rullyadrian/octolight/(list of files, cad)

Other CAD files:
drawing/arduino-mkr.dwg
