rullyadrian/octolight/octolight.kicad_pcb

## KiCad design octolight.kicad_pcb (2019-12-01)

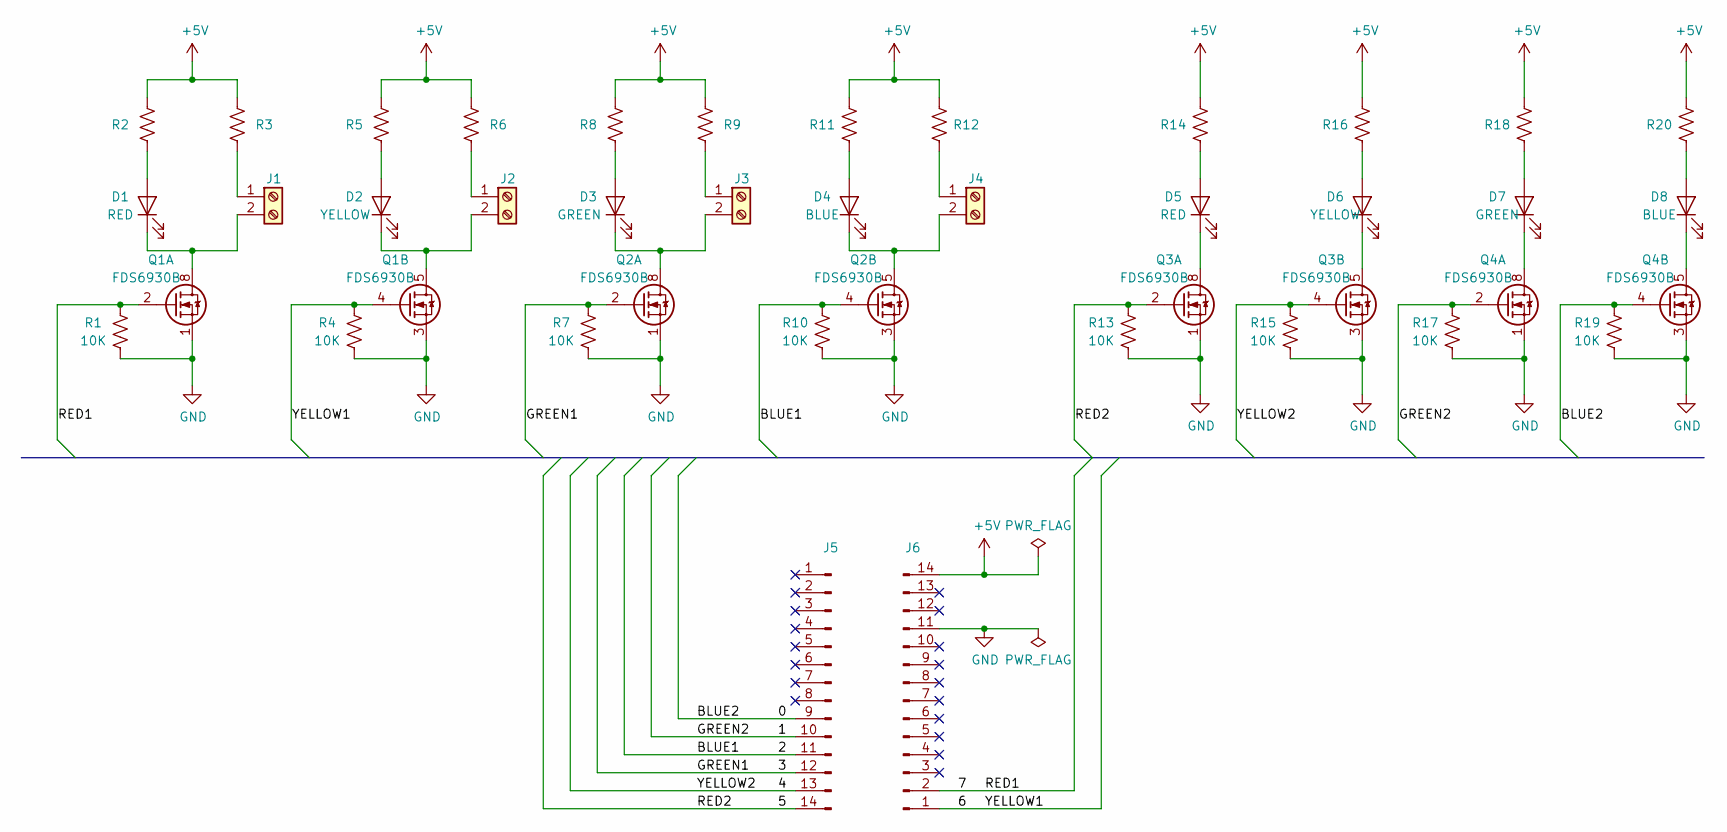
[picture p2: schematic octolight.sch]

Parts:
D1, D5: RED; LED_0805_2012Metric_Pad1.15x1.40mm_HandSolder
D2, D6: YELLOW; LED_0805_2012Metric_Pad1.15x1.40mm_HandSolder
D3, D7: GREEN; LED_0805_2012Metric_Pad1.15x1.40mm_HandSolder
D4, D8: BLUE; LED_0805_2012Metric_Pad1.15x1.40mm_HandSolder
J1, J2, J3, J4: Screw_Terminal_01x02; TerminalBlock_TE_282834-2_1x02_P2.54mm_Horizontal
J5, J6: Conn_01x14_Male; PinHeader_1x14_P2.54mm_Vertical
Q1, Q2, Q3, Q4: FDS6930B; SOIC-8_3.9x4.9mm_P1.27mm
R1, R4, R7, R10, R13, R15, R17, R19: 10K; R_0805_2012Metric_Pad1.15x1.40mm_HandSolder
R2, R3, R5, R6, R8, R9, R11, R12, R14, R16, R18, R20: R_US; R_0805_2012Metric_Pad1.15x1.40mm_HandSolder

Connections:
+5V: J6.14, R2.2, R3.2, R5.2, R6.2, R8.2, R9.2, R11.2, R12.2, R14.2, R16.2, R18.2, R20.2
/0: J5.9, Q4.4 (G2), R19.2
/1: J5.10, Q4.2 (G1), R17.2
/2: J5.11, Q2.4 (G2), R10.2
/3: J5.12, Q2.2 (G1), R7.2
/4: J5.13, Q3.4 (G2), R15.2
/5: J5.14, Q3.2 (G1), R13.2
/6: J6.1, Q1.4 (G2), R4.2
/7: J6.2, Q1.2 (G1), R1.2
GND: J6.11, Q1.1 (S1), Q1.3 (S2), Q2.1 (S1), Q2.3 (S2), Q3.1 (S1), Q3.3 (S2), Q4.1 (S1), Q4.3 (S2), R1.1, R4.1, R7.1, R10.1, R13.1, R15.1, R17.1, R19.1
unnamed: D1.1 (K), J1.2, Q1.7 (D1), Q1.8 (D1)
unnamed: D1.2 (A), R2.1
unnamed: D2.1 (K), J2.2, Q1.5 (D2), Q1.6 (D2)
unnamed: D2.2 (A), R5.1
unnamed: D3.1 (K), J3.2, Q2.7 (D1), Q2.8 (D1)
unnamed: D3.2 (A), R8.1
unnamed: D4.1 (K), J4.2, Q2.5 (D2), Q2.6 (D2)
unnamed: D4.2 (A), R11.1
unnamed: D5.1 (K), Q3.7 (D1), Q3.8 (D1)
unnamed: D5.2 (A), R14.1
unnamed: D6.1 (K), Q3.5 (D2), Q3.6 (D2)
unnamed: D6.2 (A), R16.1
unnamed: D7.1 (K), Q4.7 (D1), Q4.8 (D1)
unnamed: D7.2 (A), R18.1
unnamed: D8.1 (K), Q4.5 (D2), Q4.6 (D2)
unnamed: D8.2 (A), R20.1
unnamed: J1.1, R3.1
unnamed: J2.1, R6.1
unnamed: J3.1, R9.1
unnamed: J4.1, R12.1

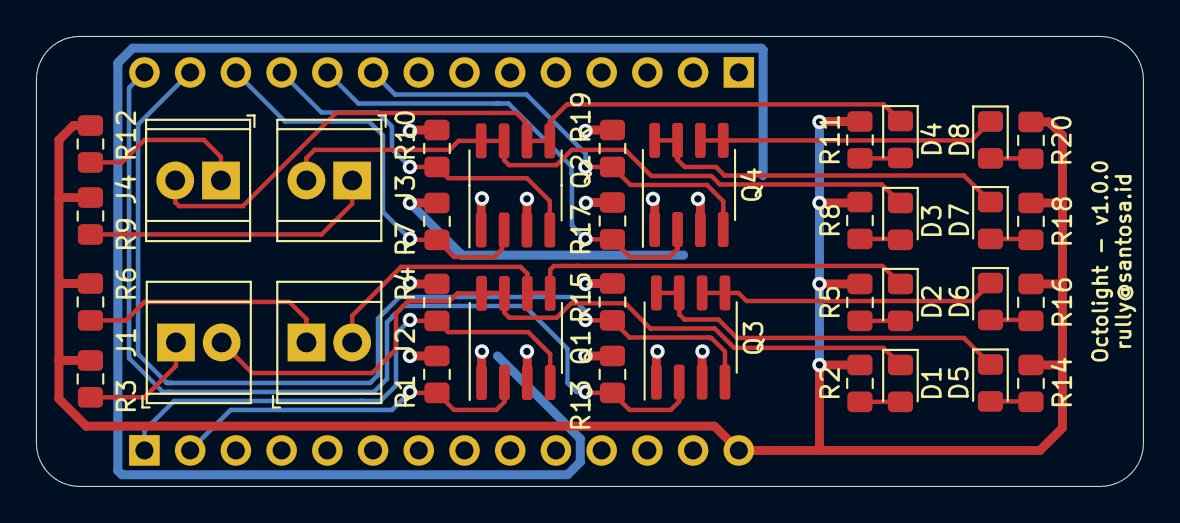
[picture p3: board octolight.kicad_pcb from above]

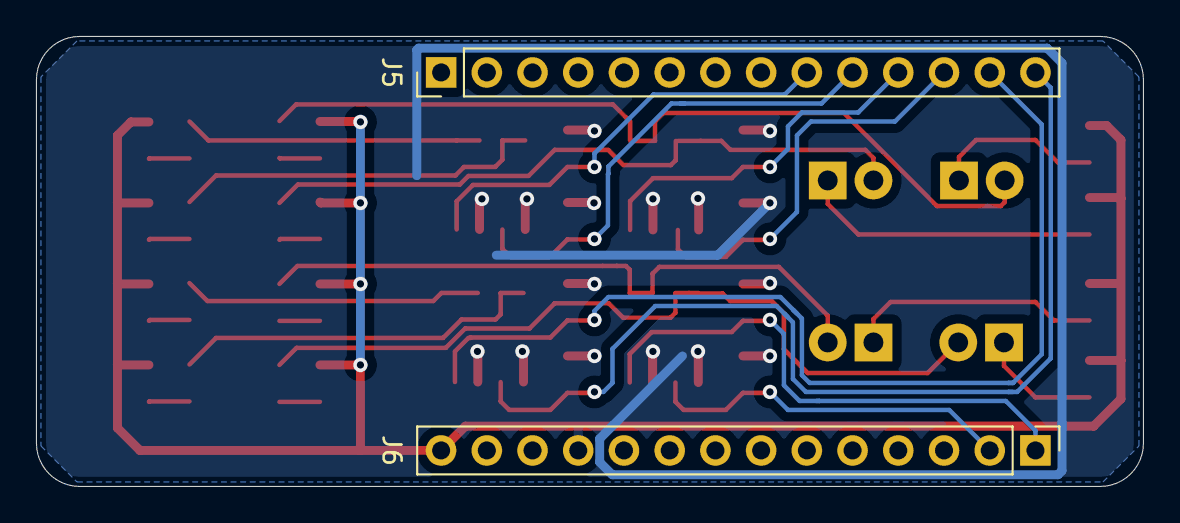
[picture p4: board octolight.kicad_pcb from below]

Board: 2 copper layers, 61.5 x 25.0 mm, 38 parts (2 on the bottom side), 30 nets.
