rullyadrian/octolight/(commit log)

2019-12-01 Add drawing of Arduino MKR board
    [arduino-mkr.dwg]
2019-12-01 Add KiCad project
    [octolight.kicad_pcb, octolight.sch]
2019-12-01 Add generated Gerber files
    [octolight-B_Cu.gbr, octolight-B_Mask.gbr, octolight-B_SilkS.gbr, octolight-Edge_Cuts.gbr, octolight-F_Cu.gbr, octolight-F_Mask.gbr, octolight-F_SilkS.gbr, octolight-NPTH.drl]
